ANDmike1/esp-/docs/hardware/01-requirements.md

# 01 — 需求冻结（电机电源驱动板）

| 项目 | 内容 |
|---|---|
| **项目名称** | 嵌赛 — 电机电源驱动板 |
| **工作模式** | **快速模式**（用户选择 A） |
| **日期** | 2026-05-06 |
| **用户授权** | 用户选择快速模式并指定范围「电机电源驱动板」，**授权对未填写项采用下文 [假设]**；你可随时更正任意一条。 |

---

## 工程约束表

| 维度 | 内容 | 状态 |
|---|---|---|
| **场景** | 竞赛/实验小车：双路直流电机驱动 + 逻辑/传感器供电；板载或独立电源模块 | [假设] |
| **供电输入** | 标称 **12 V** 蓄电池或适配器；母线需承受 **双电机同时堵转约 8 A 峰值**（单电机堵转约 4 A） | 已知（来自你先前说明） |
| **输出轨** | **12 V VM**；**5 V** 仅霍尔编码器；**3.3 V** 供 ESP32 板（IMU/超声/屏）；电流估算含 **1.5× 裕量**见 `04-constraints.md` | 已知 |
| **输入保护** | **无保险丝**；入口策略以 **肖特基** 为主（防反接串联等），详见 `03-components.md` | 已知 |
| **电机接口** | 左右电机功率端子 + 编码器/信号端子（与现有连接器语义一致即可） | [假设] |
| **通信/调试** | 无独立无线模块要求；以排针引出至主控板 | [假设] |
| **环境** | 室内赛项为主；**−20～+60 °C** 粗范围；无防水强制要求 | [假设] |
| **尺寸** | 与现有机械结构兼容；优先 **2 层板**、嘉立创工艺 | [假设] |
| **成本** | 学生/比赛预算，优先 LCSC/嘉立创可购 | [假设] |
| **认证** | 无强制 CE/FCC；课堂/赛场自用 | [假设] |
| **供应链偏好** | **混合折中**（关键功率/易损件可海外主流，连接器被动国产） | [假设] |
| **EDA** | **嘉立创 EDA**（与你当前工程一致） | [假设] |
| **制造** | 手工焊接比例高 → **优先可选贴片中较大封装**（你已反馈 TPS62135 焊接困难） | 已知 |

---

## 结构化优先级（快速模式默认）

未单独问卷时，采用以下默认取向（与「比赛迭代快 + 可焊性」一致）：

| 取向 | 本次默认 |
|---|---|
| 低功耗 | 次要（有线供电为主） |
| 低成本 | **重要**（但不以牺牲母线裕量为代价） |
| 快速落地 / 可调试 | **最重要** |
| 国产供应链 | **倾向混合**：电源芯片可 TI/成熟料，功率 MOS/驱动按 LCSC 备货选 |

若与你不符，请回复要改的 1～2 条即可。

---

## [假设] 清单（需你事后确认）

1. 主控不在本板，本板仅 **电源 + 双路电机驱动 + 去耦/保护**。  
2. **5 V / 3.3 V** 峰值电流单路 **≤ 2 A** 量级足够（若带多舵机需上调）。  
3. 输入允许 **反接保护** 以保险丝 + TVS 为主；是否加理想二极管/ORing 未强制。  
4. **LM2596** 作为 TPS62135 的「易焊备选」仅针对降压部分；需重新画原理图与布局，非 pin-to-pin。

---

## Gate 1 自检

- [x] 约束表已覆盖场景、供电、环境、成本、认证、供应链。  
- [x] 已给出优先级默认（快速落地 + 混合供应链）。  
- [x] **快速模式**：用户已选模式并指定题目，且授权假设推进。  

**下一步**：阅读 `02-architecture.md` 中三类架构对比并选定方向（若无回复则按文档中的**推荐方案 C**继续细化选型）。
