ANDmike1/esp-/docs/hardware/02-architecture.md

# 02 — 架构候选（电机电源驱动板）

| 项目 | 内容 |
|---|---|
| **项目名称** | 嵌赛 — 电机电源驱动板 |
| **日期** | 2026-05-06 |
| **用户锁定** | **方案 C**；降压采用用户库存 **LM2596 TO-263 固定 5 V / 固定 3.3 V**；**不设保险丝**（焊盘与实物不一致）；输入侧 **仅用肖特基**（见下文说明）；电感封装 **0650**；电机驱动 **AT8236**。 |

---

## 三类候选架构对比

| 方案 | 供应链取向 | 架构要点 | 关键器件范围 | 优点 | 缺点 | 适用 |
|---|---|---|---|---|---|---|
| **A — 国产优先** | 国产功率器件 + 国产/台系电源 | 双路 **集成 H 桥/驱动 IC**（如 AT8236 路线）+ **国产 DC-DC**（如 MP2315、XL7005 等，需按 12 V→5/3.3 V 具体选型）+ 输入 TVS/保险丝 | 驱动：集成方案；降压：MPS/矽力杰/芯洲等易购系列 | BOM 易在 LCSC 凑齐、成本可控 | 参考设计分散，需自己验证环路/EMI | 强国产化要求、成本敏感 |
| **B — 海外主流** | TI 等参考设计多 | **AT8236** + **TPS62135** 双路 Buck（3.3 V / 5 V）+ TVS + 保险丝；母线铺铜按 **8 A** 设计 | TPS62135、AT8236、SMBJ 系列 TVS | 效率与文档成熟、体积小 | **TPS62135 为 2×3 mm QFN**，手工焊接难度大（你已遇到） | 有小批量贴片或热风枪经验 |
| **C — 混合折中（推荐）** | 驱动维持成熟集成方案 + 降压改易焊封装 | **AT8236×2** + **LM2596-5.0 / LM2596-3.3（或 LM2596-ADJ）** 分立 Buck（TO-220/TO-263）+ 肖特基续流 + 功率电感；或 **SOIC-8 PowerPAD 类 TI TPS54331** 若体积可接受 | AT8236、LM2596、SS34/1N5822、电解/陶瓷 | **焊接友好**、调试直观、12 V 输入成熟 | 体积大、异步 Buck 效率低于同步方案、二极管与电感选型要多一步 | **课堂/比赛手工焊为主（与你现状最匹配）** |

---

## 推荐结论

- **默认推荐：方案 C（混合折中）**  
  - **理由**：与「手工焊接困难」「通电曾出现 5 V/3.3 V 短路需排查」等现状一致；LM2596 或 TO-263 贴片封装降低焊接门槛，便于排障。  
  - **方案 B** 保留为「体积紧凑 + 已能贴片」时的升级路径。  
  - **方案 A** 适合你把降压芯片进一步国产化时，需额外时间做电感/环路验证。

---

## 推荐系统框图（文本）

```
12V_IN ──[串联肖特基 防反接可选]──+── VM(12V) ──┬── AT8236(L) ── 电机L / 霍尔编码器供电出口
（不设保险丝）                    │              └── AT8236(R) ── 电机R / …
                                │
                                ├── LM2596-5.0(TO-263) ── 5V ──→ 仅双路霍尔编码器
                                │
                                └── LM2596-3.3(TO-263) ── 3.3V ──→ ESP32 板（IMU/超声/屏；OpenMV 多为串口）

GND：单板大面积铺地；浪涌保护若省略 TVS，则仅剩肖特基无法吸收高能尖峰 —— 见 `03-components` 风险提示。
```

---

## Gate 2 自检

- [x] 已比较国产优先 / 海外主流 / 混合三类。  
- [x] 每类均覆盖 **驱动 + 电源 + 保护** 范围。  
- [x] **用户已确认方案 C**，并补充电源结构与负载划分（见 `04-constraints` 电流估算）。
