ANDmike1/esp-/docs/hardware/04-constraints.md

# 04 — 接口、电源树、电流估算与 PCB 约束

| 项目 | 嵌赛 — 电机电源驱动板 |
|---|---|
| 日期 | 2026-05-06（修订） |
| 修订 | **高亮背光**：1.3″ 屏按 **亮色背光 TFT** 提高电流项并重算 ×1.5 |

---

## 负载说明（由你提供）

| 电源轨 | 本板上的用途 |
|---|---|
| **5 V** | 仅 **双路电机霍尔编码器**（无其它大电流外设） |
| **3.3 V** | 供 **ESP32 板**；板上外设含 **IMU、超声波、1.3″ 屏**；之后可能 **接 OpenMV（多为串口）** —— 通常 OpenMV 相机本机用 **USB 5 V** 独立供电，**若你坚持 OpenMV 也从本板 3.3 V 取电** 需另加一路预算（见下表注）。 |

**12 V VM**：双路 **AT8236**，单电机堵转约 **4 A**、两路同时约 **8 A 峰值**（与此前一致）；**无保险丝**，走线/接插件按此留裕量。

---

## 电流估算与 **1.5× 设计裕量**（工程估算，非测量值）

### 5 V 轨（霍尔编码器）

| 项 | 经验范围 | 本方案取值（说明） |
|----|---|---|
| 两路霍尔 + 上拉/接口 | 约 **20～80 mA** 量级（与具体编码器芯片、上拉阻值有关） | 取偏保守 **I₅,est ≈ 0.10 A（100 mA）** |
| **×1.5 余量** |  | **I₅,design ≈ 0.15 A** → **布线与 Buck 按 ≥ 0.2 A 能力备料** 即可（LM2596 能力远大于此，热与线宽压力很小） |

**结论**：5 V 走线 **0.3～0.5 mm 外层** 已很宽裕；重点在 **不要与 12 V/开关节点搞混极性**。

---

### 3.3 V 轨（ESP32 + IMU + 超声 + 1.3″ 屏）

以下按 **可能同时工作** 的偏保守加算（未计 OpenMV 从 3.3 V 强灌大电流）：

| 负载 | 经验电流（数量级） | 备注 |
|---|---|---|
| **ESP32-S3**（WiFi 开、一般业务） | **0.30～0.50 A** 持续，**发射尖峰** 可更高 | 无单独 RF 功率表时，用 **0.45 A** 作持续估算 |
| **IMU** | **~0.005 A** | I²C 芯片 |
| **超声测距**（如 HC-SR04 类） | **~0.015 A** 工作 | 间歇，与 WiFi 峰错开，但算进基线 |
| **1.3″ 屏（亮色背光 TFT）** | **约 0.15～0.22 A**（背光+驱动粗算，偏亮档位） | **已确认：背光由 3.3 V 供电**；取 **0.20 A** 计入 **I₃,base**，**不拆到 5 V 轨** |
| **小计 I₃,est** | 约 **0.45 + 0.005 + 0.015 + 0.20 ≈ 0.67 A** | — |
| **取整为基线负载（工程）** | **I₃,base ≈ 0.70 A** | 覆盖 WiFi 一般负载 + **高亮背光** 同时存在 |

**×1.5 余量（你要求）**

\[
I_{3,\mathrm{design}} = 1.5 \times I_{3,\mathrm{base}} \approx 1.5 \times 0.70\,\mathrm{A} \approx \mathbf{1.05\,\mathrm{A}}
\]

**设计建议（更新）：**

- **Buck / 电感 / TO-263 散热**：按 **连续 ~1.1 A** 为最低目标，**建议按 ~1.2 A** 连续能力布置 **铜宽、过孔、0650 电感 Isat**（纹波电流叠加后峰值更高，电感 **Isat** 建议 **≥ 2～3 A** 档位查阅手册曲线）。LM2596 芯片壳温与肖特基散热也要随之复核。  
- **PCB 走线**：**3.3 V 母线到 ESP32/屏供电分叉** 建议 **≥ 1.2 A** 档线宽或铺铜；分叉后 **屏供电窄段** 单独核一遍。  
- **去耦**：ESP32 模块电源脚附近 **≥ 100 µF 低 ESR 电解/固态 + 多层陶瓷**（具体按模组手册）。

**OpenMV 注**：若仅为 **UART/USB 透传**，相机仍 **USB 供电**，则 **不增加** 上述 **1.05 A**。若未来改为 **整相机由本板供电**，需单列预算。

---

## 汇总表（设计用）

| 轨 | 估算负载（长期） | **×1.5 后设计电流** | LM2596 |
|----|---|---|---|
| 5 V | ~0.10 A | **≥ ~0.15 A（建议按 0.2 A 档布置）** | TO-263 固定 5 V |
| 3.3 V | ~**0.70 A**（含 **高亮背光** 屏） | **≥ ~1.05 A（布线/Buck/电感按 ~1.2 A）** | TO-263 固定 3.3 V |
| 12 V VM | 峰值 ~8 A（电机） | **母线/器件不变** | — |

---

## PCB / 热（简要）

- **12 V**：仍建议 **铺铜 + 多过孔**；无保险丝则更依赖 **电池与线束不过载**。  
- **LM2596**：输入/输出电容紧靠脚位；续流二极管、电感环路最短；**0650 电感**注意 **饱和电流**。  
- **AT8236**：散热焊盘接地过孔。

---

## 产测顺序建议

1. **空载**：测 **5 V、3.3 V** 电压正确。  
2. **先仅接编码器 5 V**，再 **接 ESP32 3.3 V**（限流电源）。  
3. 最后再挂电机 **12 V** 大功率测试。
