ANDmike1/esp-/docs/hardware/06-decisions.md

# 06 — 决策门（修订）

| 类别 | 内容 |
|---|---|
| **已确定** | **方案 C**；**AT8236**；**LM2596 TO-263 固定 5 V / 3.3 V（库存）**；电感 **0650**；**取消保险丝**；入口仅用肖特基的方案需在板上标明是 **防反接串联**还是另有含义（见 `03`）；**检流电阻已改为 2512（≥2 W 档）**。 |
| **电流设计目标（含 1.5×）** | **5 V**：霍尔 → ~0.10 A，×1.5 → **≥0.15 A（布线 ~0.2 A）**。**3.3 V**：**屏背光由 3.3 V 供电**（已确认），亮色背光 → 基线 **~0.70 A**，×1.5 → **≥~1.05 A（建议布线/Buck/电感按 ~1.2 A）**；详见 `04-constraints`。 |
| **OpenMV** | 预设 **串口连接 + USB 独立供电**；若改为板供电须在改版需求中单列电流。 |
| **高风险** | 无保险丝/可选无 TVS → **浪涌与过流无熔断点**；务必核对 **线径、接插件、电池保护（若在外部）**。入口肖特基已定 **SK104B（SMB）**，注意 **铺铜散热**。 |
