ANDmike1/esp-/md/嵌赛全技能联调/本回合说明.md

# 嵌赛全技能联调 — 本回合说明

**日期**：2026-04-16  

## 覆盖的技能

| 技能 | 本回合验证方式 |
|---|---|
| `project-workspace-conventions` | 使用 `md/`、`code/` 约定；新建 `md/` 子目录归档本会话 md。 |
| `safe-file-operations` | 未执行高风险移动/删除；仅追加创建文件。 |
| `agent-session-md-archive` | 会话摘要文件夹名：`嵌赛全技能联调`；本会话相关 md 置于其下。 |
| `workspace-readme-changelog` | 根目录 `README.md` 仅写目录与用法；流水写入 `log.txt`。 |

## 说明

此为联调测试生成的文档，可随后续会话继续在同目录补充或按新摘要新建兄弟目录。
