ANDmike1/esp-/docs/hardware/03-components.md

# 03 — 关键器件选型（电机电源驱动板 · 方案 C · 已对齐库存）

| 项目 | 内容 |
|---|---|
| **日期** | 2026-05-06（修订） |
| **前提** | **AT8236×2**；**LM2596 TO-263 固定 5 V / 固定 3.3 V（已有物料）**；电感 **0650**；**无保险丝**；输入侧策略见下。**电流估算见 `04-constraints`。 |

> 下单前请在 LCSC/经销商再次核对料号与封装；参数以 **datasheet** 为准。

---

## 12 V 输入（用户要求：不要保险丝；仅用肖特基）

| 做法 | 说明 |
|---|---|
| **串联肖特基（典型用于防反接）** | 在 **12 V+** 串一只 **VRRM ≥ 40 V**、电流 ≥ 母线峰值（建议 ≥ **10～15 A** 脉冲能力档）的肖特基，反接时截止。**代价**：压降约 **0.3～0.5 V**，LM2596、AT8236 的 **最低输入电压**与发热需重算。 |
| **与你表述「只单独使用肖特基」** | 若 **不接 TVS**：无法替代保险丝的 **过流切断**；也无法替代 TVS 对 **感性尖峰/浪涌钳位**。比赛长线束仍建议 **并联一只 TVS 到地**（可与肖特基并存）。若结构上限死只用一颗二极管，优先弄清它是 **防反接串联** 还是误把 TVS 当肖特基 — **二者功能不同**。 |

**已从 BOM 删除**：保险丝及其焊盘。

---

## Buck（你已确认的物料）

| 轨 | 芯片（示例系列） | 封装 | 备注 |
|----|---|---|---|
| **5 V** | **LM2596** 固定 **5 V**（TO-263-5） | TO-263 | 负载仅占 **双路霍尔编码器**，电流极小（见 `04`）。 |
| **3.3 V** | **LM2596** 固定 **3.3 V**（TO-263-5） | TO-263 | 供 **ESP32 板**，含 IMU、超声、1.3″ 屏；OpenMV 多为 **UART**，相机通常 **USB 5 V 独立供电**，若不共 3.3 V 负载则不计入本轨电流。 |

- **续流二极管**：LM2596 异步 Buck 必选肖特基（如 **SS54 / MBR2045** 等，耐压与电流按 TI 典型应用）——与你「电源入口只用一颗肖特基」**不是同一颗**，此处为 **Buck 续流**。  
- **储能电感**：封装 **0650**（按你库存物料）；电感量仍在 **LM2596 手册典型范围（多为数十 µH）**，关键是 **Isat** 大于 **电感峰值电流**（按下面估算的 **1.5× 负载** + 纹波电流估算）。

---

## 电机驱动

| 模块 | 器件 | 备注 |
|---|---|---|
| 左/右电机 | **AT8236** | VM、采样电阻按此前堵转 **4 A/路**、母线 **8 A** 规划布线。 |

采购/datasheet 线索仍可用 LCSC 搜 **AT8236** / 原 C 号；以你实际下单料号为准。

---

## 小体积 Buck 备选（本板不优先）

- **TPS62135**：仅当你能稳定焊接 **2×3 mm QFN** 时；见历史记录。链接仍可用 [C167238](https://www.lcsc.com/product-detail/C167238.html) / [TI TPS62135 PDF](https://www.ti.com/lit/ds/symlink/tps62135.pdf)。

---

## 风险与验证动作（修订）

| 风险 | 建议 |
|---|---|
| 无保险丝、无 TVS | 过流/浪涌靠 **线束/电池/PCB 铜皮** 硬抗 → 线宽与接插件额定电流要够；**建议至少保留 TVS 或浪涌吸收** 二选一。 |
| 防反接肖特基压降 | 低电量时 **LM2596 压差** 不足会失稳；用 **示波器** 看 **最低电池电压** 下 5 V/3.3 V 是否仍稳。 |
| 3.3 V 电流被低估 | 见 `04` 的 **1.5× 表**；若给 **整板 OpenMV 5 V 供电** 从别处取，则不要算进 3.3 A。 |

---

## Gate 3 说明

- 批量下载 **LM2596、AT8236** 的 PDF 与 0650 电感规格书到 `docs/hardware/datasheets/` 可另开任务执行。
