ANDmike1/esp-/docs/hardware/07-bom.md

# 07 — BOM 表（电机电源驱动板 · 方案 C）

| 项目 | 内容 |
|---|---|
| **工程** | 嵌赛 — 电机电源驱动板 |
| **日期** | 2026-05-06 |
| **前提** | **无保险丝**；**LM2596 TO-263** 固定 **5 V / 3.3 V**；电感 **0650**；**AT8236×2**；屏背光 **3.3 V**、亮色负载已计入 `04-constraints`。 |

**说明**：下列 **LCSC 商品编号（C 号）** 为常用检索入口，**下单前请在立创商城按最终封装、耐压、阻值再次核对**；阻容精确值请在你原理图中按 LM2596 / AT8236 手册典型应用细化。

---

## 1. 汇总表（按位号）

| 序号 | 位号（建议） | 名称 | 型号 / 规格（示例） | 封装 | 数量 | LCSC（示例/检索） | 备注 |
|---|---|---|---|---|---|---|---|
| 1 | **J_IN** | 电源输入端子 | 2 Pin 3.81 mm 或同等 | 插件 | 1 | 搜「KF301」「螺钉端子 2P」 | 线径与电流≥母线峰值 |
| 2 | **D_IN** | 防反接肖特基 | **SK104B**（VRRM **40 V**）或同系列 **10 A / SMB（DO-214AA）** | **SMB** | 1 | 按订货型号搜 LCSC | **已确认可用**；入口 **铺铜散热**；串联 **压降 ~0.5 V@大电流** |
| 3 | **D_TV** | TVS（可选但强烈建议） | **SMBJ15CA** 或按电池钳位重选 | SMB | 1 | [C910054](https://www.lcsc.com/product-detail/C910054.html) 等 | 与「仅用肖特基」可并存；贴 **12 V–GND** |
| 4 | **C_VM_H** | VM 高频退耦 | **0.1 µF / 50 V** X7R | 0603/0805 | 2～4 | C 类陶瓷通用 | 紧靠 AT8236 VM / LM2596 Vin |
| 5 | **C_VM_B** | VM 储能电解 | **47 µF / 25 V**（或更大封装电解） | 径向/贴片电解 | 2 | 按封装选 | 近驱动 / 近电源入口分区放置 |
| 6 | **U1** | 电机驱动 | **AT8236_Left**（或兼容左封装） | ESOP-8 | 1 | [C2827823](https://www.lcsc.com/product-detail/C2827823.html) 等 | 以实际下单 Left/Right 料号为准 |
| 7 | **U2** | 电机驱动 | **AT8236_Right** | ESOP-8 | 1 | 同上系列 | 同上 |
| 8 | **R_SEN1/R_SEN2** | 检流电阻（若原理图保留） | **0.1 Ω** / **1%** / **≥2 W 量级** | **2512**（已由用户确认更换） | 2 | 搜「0R1 2512 2W」 | 开尔文布线；堵转约 **1.6 W** |
| 9 | **U3** | Buck 5 V | **LM2596S-5.0**（固定 5 V） | **TO-263-5** | 1 | 搜「LM2596S-5.0 TO-263」 | 你已持有物料则不改 |
| 10 | **U4** | Buck 3.3 V | **LM2596S-3.3**（固定 3.3 V） | **TO-263-5** | 1 | 搜「LM2596S-3.3 TO-263」 | 同上 |
| 11 | **D5** | LM2596（5 V）续流肖特基 | **≥40 V**、**≥3 A**（如 SS54、肖特基 TO-252） | SMA/插件 | 1 | 搜「SS54」「肖特基 5A」 | **非** D_IN |
| 12 | **D6** | LM2596（3.3 V）续流肖特基 | 同上 | 同上 | 1 | 同上 | 同上 |
| 13 | **L5** | Buck 5 V 储能电感 | **0650 封装**；电感量 **33～150 µH**（按 LM2596 公式与开关频率算） | 0650 | 1 | 按你库存料号 | **Isat ≥ 2～3 A** 推荐 |
| 14 | **L6** | Buck 3.3 V 储能电感 | 同上；**3.3 V 轨按 ~1.2 A 设计** | 0650 | 1 | 同上 | **Isat** 留足裕量 |
| 15 | **CIN5/CIN6** | LM2596 输入电容 | **100 µF / 25 V** + **0.1 µF** | 电解+0603 | 各 2 组 | 通用 | 各自紧靠 **U3/U4** Vin |
| 16 | **COUT5** | 5 V 输出滤波 | **220 µF / 16 V** + 陶瓷 **10 µF** | 电解+0603 | 1+1 | 通用 | 低温漂、低 ESR 更佳 |
| 17 | **COUT6** | 3.3 V 输出滤波 | **220～470 µF / 10 V** + **10 µF** | 同上 | 1+1 | 通用 | 供 ESP32 板入口 |
| 18 | **J_HALL** / **J_ENC** | 霍尔 / 编码器接口 | 排针 2.54 | 插件 | 若干 | — | 与机械结构一致 |
| 19 | **J_5V/J_3V3/J_GND** | 至 ESP32 / 外设 | 排针或锁紧座 | 插件 | 若干 | — | 电流能力≥ **1.2 A**（3.3 V） |
| 20 | **J_MOTOR_L/R** | 电机线 | 6 Pin 等（与原 PCB 一致） | 插件 | 2 | — | 见原理图网络名 |

---

## 2. 按功能块核对清单（不含结构件）

| 功能块 | 必含器件 |
|---|---|
| **12 V 入口** | 端子；可选 **D_IN**；可选 **D_TV**；VM 电解/陶瓷 |
| **双路驱动** | **U1/U2 AT8236**；VM 退耦；检流 **R_SEN**（若使用）；OUT 至端子 |
| **Buck 5 V** | **U3 LM2596-5**；**D5**；**L5**；Cin/Cout |
| **Buck 3.3 V** | **U4 LM2596-3.3**；**D6**；**L6**；Cin/Cout |
| **引出** | 5 V 霍尔；3.3 V ESP32；GND 充分 |

---

## 3. 已从 BOM 排除（与你的决策一致）

| 器件 | 原因 |
|---|---|
| **保险丝及焊盘** | 焊盘与实物不一致，已取消 |
| **TPS62135** | 焊接困难；改 LM2596 |

---

## 4. 订购前必须手算/核对的三项

1. **L5/L6 电感量**：用 TI LM2596 datasheet 或 Webench，按 **Vin=12 V**、**Vout=5/3.3 V**、电流 **~1.5～3 A 峰值能力** 选定 **µH**，不能只抄别人板。  
2. **Isat**：0650 电感饱和电流 **≥** 对应 Buck 峰值电感电流（含纹波）。  
3. **D_IN**：若不用防反接管，原理图标 **「绝不允许反接」**；若使用，核算 **最低电池电压** 下 LM2596 是否仍满足 **压差**。

---

## 5. 导出与归档

- 本表可与嘉立创 EDA **物料清单** 交叉校验：EDA 导出 BOM 后，将 **厂商型号、封装** 与本表 **规格列** 对齐。  
- 下一步若要 **合并进 PDF**，可按 `hardware-solution` 流程运行 `md_to_pdf.py`（见 `.cursor/skills`）。

---

## 6. 库存对照与电气核算（按你确认的序号）

**对照**：1✓ **2=SK104B（SMB 入口，已确认）** 3不用 4✓ 5直插铝电解 6✓7✓ **8=2512 0R1** 9✓10✓ 11✓12✓ 13=33µH 14✓ 15=100µF电解+0603 0.1µF 16✓17✓ 18✓19✓20✓  

### 6.1 结论总览

| 序号 | 结论 | 说明 |
|---|---|---|
| **2 入口肖特基** | **✅ SK104B（SMB）可用** | **IF(AV)=10 A** 档、**~8 A 堵转**在额定内；注意 **VF×I 发热**，阴极/阳极 **大面积铺铜**（见 VF 曲线 ~**0.5 V@10 A** 量级）。 |
| **8 检流 0.1 Ω** | **✅ 已改为 2512（用户确认）** | 堵转 **4 A** 时 **P≈1.6 W**：须选 **额定 ≥2 W** 的 **2512** 料号；保留 **开尔文** 至 AT8236 **ISEN**；焊接注意焊盘散热。 |
| **13 L5 = 33 µH（5 V 轨）** | **可用（粗算）** | **12 V→5 V**、负载按 **~0.2 A**、**f≈150 kHz** 量级粗算，纹波电流约 **0.5～0.6 A** 峰峰值量级时，电感电流峰值约 **0.2+0.3≈0.5 A** → **0650 电感 Isat ≥1 A** 通常即可；仍以 **数据手册 + 你手上电感的 Isat 实测曲线** 为准。 |
| **14 L6（3.3 V 轨）** | **须核对 Isat** | **输出按 ~1.2 A 设计** 时，粗算电感电流峰值 **≈ Iout + Δi/2**。若 **L6 也为 33 µH**、Vin=12 V，Δi 粗算仍约 **0.48 A** 量级，则 **IL_peak ≈ 1.2+0.24 ≈ 1.44 A**。请确认 **0650 料号 Isat ≥ 2 A**（推荐 **≥2.5 A**）。若 Isat 不足，改为 **更大 µH（降纹波）** 或 **更大饱和电流电感**。 |
| **11/12 续流肖特基（SS54 等）** | **一般够用** | LM2596 异步 Buck 续流二极管电流 **≈ 电感平均电流**，**5 V 路**很轻；**3.3 V 路**约 **1～1.5 A** 级，SS54 **5 A** 档通常有余量；仍以 **TO-263 LM2596 散热 + 二极管温升** 为准。 |
| **15 100 µF + 0603 0.1 µF** | **合理** | 输入电容：**电解（低频）+ 陶瓷（高频）** 经典搭配；注意 **100 µF 为电解**，**不能**做成 0603 本体——你是 **电解 + 0603 0.1 µF 并联**，表述正确。核对 **耐压 ≥25 V**。 |
| **3 不用 TVS** | **已接受风险** | 无钳位时浪涌靠线束与运气；赛场长线束仍建议日后补 **SMBJ** 类。 |
| **其余 1、4、5、6、7、9、10、16～20** | **齐套性 OK** | 按当前方案可装机；最终仍以 **原理图网络名与封装** 一致为准。 |

### 6.2 粗算公式（供你在手册里复核）

- **检流电阻功耗**：\(P \approx I^2 R\)（堵转 **4 A**、**0.1 Ω** → **≈1.6 W**）。  
- **Buck 纹波电流（量级）**：\( \Delta i_L \approx \dfrac{(V_{in}-V_{out})\,V_{out}}{V_{in}\,f_s\,L} \)（**LM2596** 请用手册中的 **\(f_s\)**；上表粗算按 **150 kHz** 量级示例）。  

### 6.3 建议优先处理的 2 件事

1. **入口二极管**：已选用 **SK104B（SMB）10 A** 档；装配时保证 **散热焊盘与铜皮**。若仍有异常温升，再考虑 **TO-252** 或取消串联防反接。  
2. ~~**检流电阻封装**~~ → **已改为 2512（≥2 W 档），请在 BOM 中核对具体料号额定功率。**

---

## 7. 下一步（衔接 `08-layout-and-bringup.md`）

- 原理图冻结 → PCB 关键网络 → 分阶段上电与 EVT；见 **`08-layout-and-bringup.md`**。
