ANDmike1/esp-/docs/hardware/05-validation.md

# 05 — 验证计划（EVT 摘要）

| 阶段 | 项目 | 方法 | 通过判据 |
|---|---|---|---|
| EVT-电 | 5 V / 3.3 V 空载 | 限流电源、万用表 | 电压在误差内，无异常升温 |
| EVT-电 | 12 V 带载电机 | 分段接电机、测电流 | 堵转电流与预期量级一致，驱动不过热 |
| EVT-可靠 | 过流/异常温升 | 实验室可控堵转、触摸热点 | **无板载保险**：依赖外部保护与人工断电；芯片不过热、无失控冒烟 |
| EVT-EMI | 母线纹波 | 示波器 VM、Vout | 纹波在 MCU/传感器可接受范围（按负载定） |
