ANDmike1/esp-/docs/hardware/08-layout-and-bringup.md

# 08 — 原理图收尾、PCB 要点与上电调试（电机电源驱动板）

| 项目 | 嵌赛 — 电机电源驱动板 |
|---|---|
| 日期 | 2026-05-06 |
| 前置 | **方案 C**；检流电阻已 **2512**；BOM 见 `07-bom.md`；电流见 `04-constraints.md`。 |

---

## 1. 原理图收尾清单（DRC 前）

| 检查项 | 说明 |
|---|---|
| **网络名统一** | **VM / 12V / GND / 5V / 3V3** 与 PCB 一致；避免同名不同网。 |
| **LM2596 固定输出** | **无 FB 分压电阻**（除非你用 ADJ）；**续流二极管方向**、**输入/输出电容极性**。 |
| **AT8236** | **VM**、**OUT**、**ISEN** 与 **2512 检流** 走线 **开尔文**；散热焊盘接 **GND**。 |
| **入口 SS54** | 若仍串联在总入口：与 **8 A 堵转** 是否匹配（见 `07-bom` §6）；否则标注 **「禁止反接」**。 |
| **无保险丝** | 原理图删除保险符号及多余网络，避免 DRC 悬空。 |

---

## 2. PCB 布局优先级（嘉立创 EDA）

| 优先级 | 区域 | 要点 |
|---|---|---|
| P0 | **12 V VM / 电机电流** | **铺铜 + 过孔**；**不换层细瓶颈**；从 **端子 → 电解 → AT8236 VM** 最短。 |
| P0 | **LM2596** | **Vin 电容贴脚**；**肖特基紧贴 SW**；**电感靠近 SW**；**开关节点面积小**。 |
| P1 | **2512 检流** | **取样脚独立** 进出芯片 **ISEN**，不与电机大电流铜皮混一段再走分支。 |
| P1 | **3.3 V 至排针** | 按 **~1.2 A** 布宽或铺铜至 **ESP32 供电针**。 |
| P2 | **丝印** | **12V/GND/5V/3V3**、**电机方向**、**极性电容**。 |

---

## 3. 分阶段上电（强烈建议）

| 步骤 | 操作 | 判据 |
|---|---|---|
| S1 | **限流电源** 仅接 **12 V 入口**（**不接电机**） | 无冒烟；各轨 **对地短路电阻** 正常（非近似短路）。 |
| S2 | 测 **5 V、3.3 V 空载电压** | **5.0±裕量 / 3.3±裕量**；LM2596、二极管微热可接受。 |
| S3 | 接 **霍尔 5 V** | 编码器工作正常。 |
| S4 | 接 **ESP32 3.3 V**（可先低压限流） | 起机、屏、WiFi 粗测。 |
| S5 | 最后接 **电机 + 逐渐加大负载** | 堵转电流与温升可接受；检流波形（若有）合理。 |

---

## 4. 与 `05-validation.md` 的衔接

- **EVT-电**：对应上表 **S2～S4**。  
- **EVT-带载电机**：对应 **S5**。  
- **无保险丝**：「短路保护」一项改为 **依赖外部电池保护 / 线径 / 人工断电**，板内无熔断。

---

## 5. 完成后

- **Gerber** 导出 → 嘉立创下单助手；首板建议 **加测试点（TP）** 于 **VM、5V、3V3、GND**。  
- **投产前整板核对**：见 **`09-pre-order-checklist.md`**。
