ANDmike1/esp-/PCB.pdf

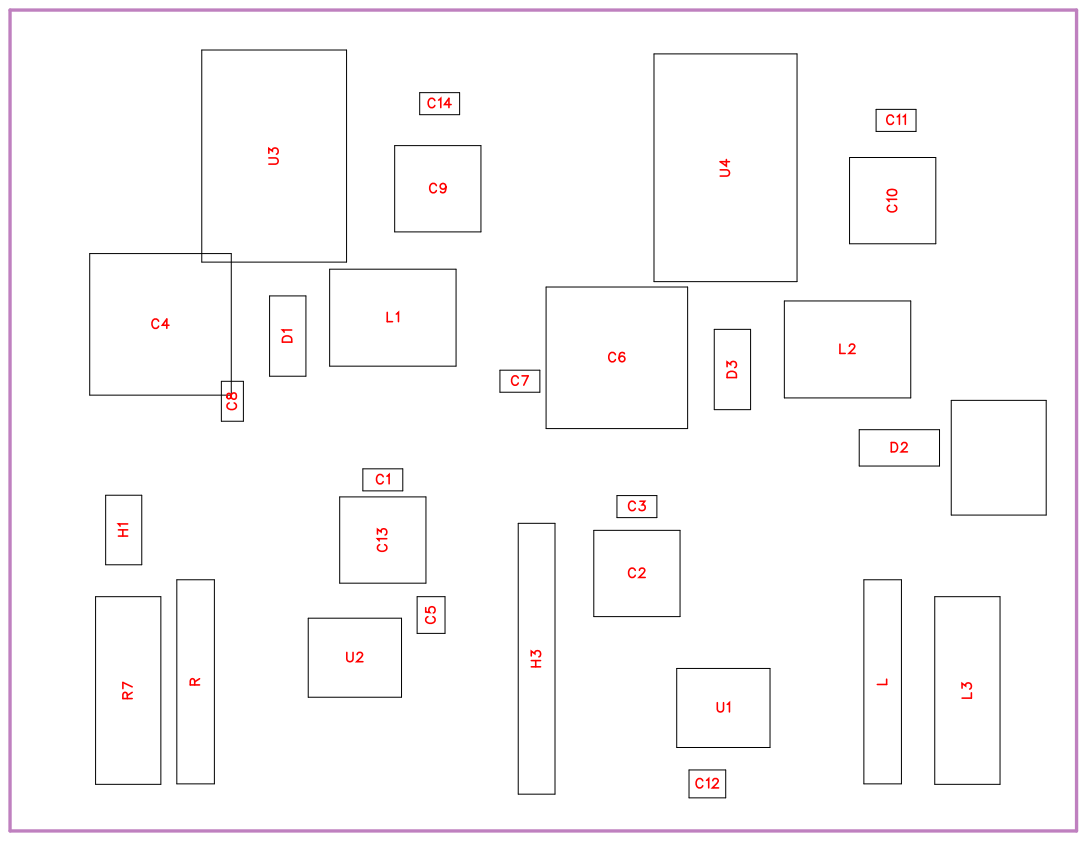
[picture p1: page 1]

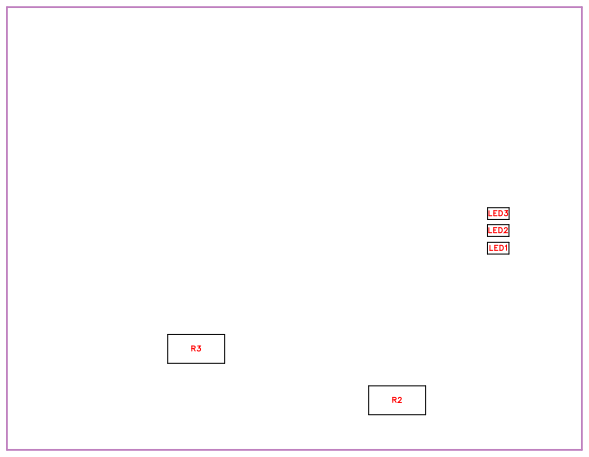
[picture p2: figure]
LED1; LED2; LED3

No. | Quantity | Comment | Designator | Footprint | Value | Manufacturer Part | Manufacturer | Supplier Part | Supplier
1 | 2 | 陶瓷电容0.1u f | C1,C3 | C0603 | 陶瓷电容0.1u f
2 | 2 | 47uF | C2,C13 | CAP-TH_BD 6.3-P2.50-D1 .0-FD | 47uF | ERS1HM470 E110T | AISHI(艾华集 团) | C106665 | LCSC
3 | 2 | 680uF | C4,C6 | CAP-TH_BD 10.0-F5.00-D 0.6-FD | 680uF | ERG35V680 M10X16 | JIERR(捷而 瑞) | C47344182 | LCSC
4 | 2 | 100nF | C5,C12 | CAP-SMD_L 2.0-W1.25 | 100nF | FCC0805B10 4K500DT | FOJAN(富捷) | C5137467 | LCSC
5 | 2 | 0.1uf | C7,C8 | C0603 | 0.1uf
6 | 2 | 220uF | C9,C10 | CAP-TH_BD 6.3-P2.50-D0 .5-FD | 220uF | ERG25V220 M6X11 | JIERR(捷而 瑞) | C47344177 | LCSC
7 | 2 | 10uf | C11,C14 | C0603 | 10uf
8 | 3 | SS54 | D1,D2,D3 | SMA_L4.3-W 2.6-LS5.0-FD | | SS54 | R+O(宏嘉诚) | C7420369 | LCSC
9 | 1 | PZ254V-11-0 2P | H1 | HDR-TH_2P-P2.54-V-M | | PZ254V-11-0 2P | XFCN(兴飞) | C492401 | LCSC
10 | 1 | PZ254V-11-0 8P | H3 | HDR-TH_8P-P2.54-V-M | | PZ254V-11-0 8P | XFCN(兴飞) | C492407 | LCSC
11 | 2 | 33uH | L1,L2 | IND-SMD_L7 .5-W6.6 | 33uH | PCR0650-33 0-M | JIERR(捷而 瑞) | C53896885 | LCSC
12 | 2 | 2016WV-06P | L3,R7 | CONN-TH_X 2016WV-06-46SN | | 2016WV-06P | HanElectricit y(瀚源) | C5448081 | LCSC
13 | 2 | A254UP-ZD0 6P | L,R | HDR-TH_6P-P2.54-V-M | | A254UP-ZD0 6P | BXCONN(宝 讯) | C41413835 | LCSC
14 | 3 | NCD0603Y2 | LED1,LED2,LED3 | LED0603-RD | | NCD0603Y2 | 国星光电 | C89811 | LCSC
15 | 2 | 100m | R2,R3 | R2512 | 100m | RE2512F3R1 00 | JIERR(捷而 瑞) | C46961760 | LCSC
16 | 1 | AT8236_Left | U1 | ESOP-8_L4. 9-W3.9-P1.2 7-LS6.0-BL-E P | | AT8236_Left | 杭州中科微 | C2827823 | LCSC
17 | 1 | AT8236_Rig ht | U2 | ESOP-8_L4. 9-W3.9-P1.2 7-LS6.0-BL-E P | | AT8236_Rig ht | 杭州中科微 | C2827823 | LCSC
18 | 1 | LM2596S-5.0 (UMW) | U3 | TO-263-5_L1 0.2-W8.9-P1. 70-BR | | LM2596S-5.0 (UMW) | UMW(友台半 导体) | C347421 | LCSC
19 | 1 | LM2596S-3.3 (UMW) | U4 | TO-263-5_L1 0.0-W8.4-P1. 70-LS15.3-B R | | LM2596S-3.3 (UMW) | UMW(友台半 导体) | C347420 | LCSC

20

1 | 1*2PIN
3.81mm
电源接线端子 | CONN-TH_
WJ15EDGV
C-3.81-2P

1*2PIN
3.81mm

KANGNEX(
康奈克斯电气 )

C8396 LCSC

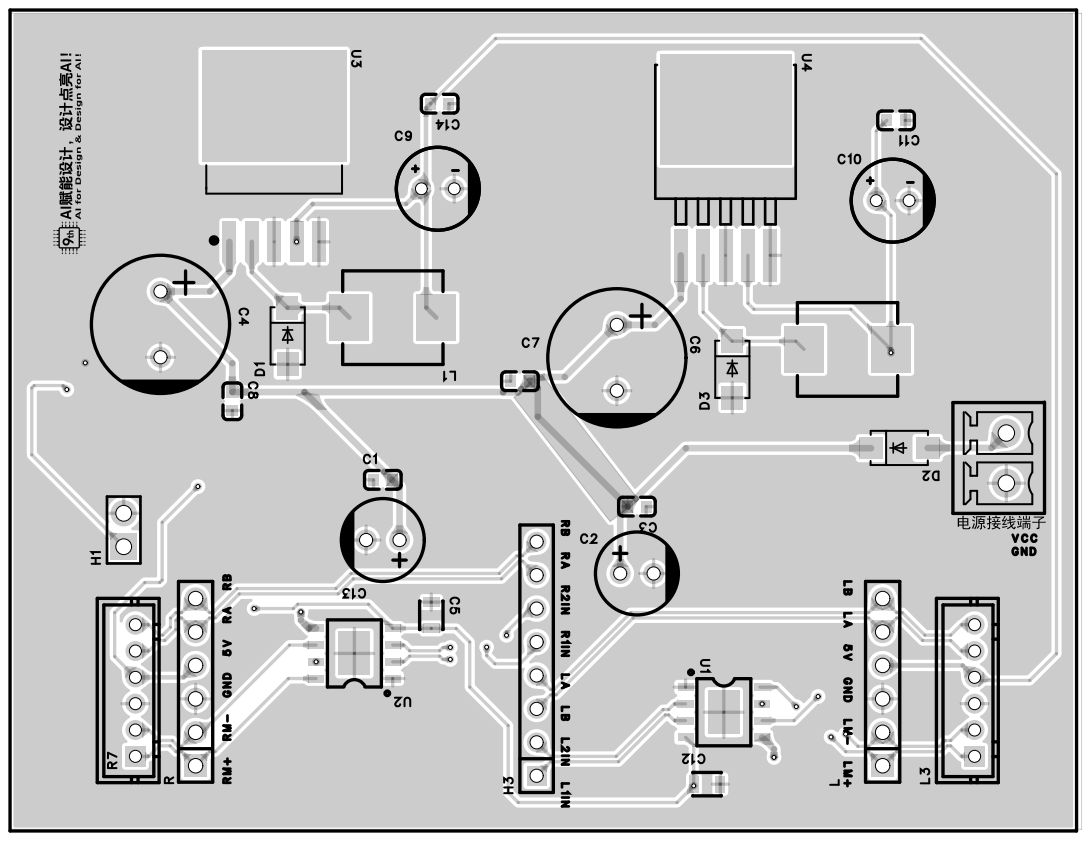
[picture p3: page 5]

LB LA 5V GND LM- LM+

RM+ RM- GND 5V RA RB

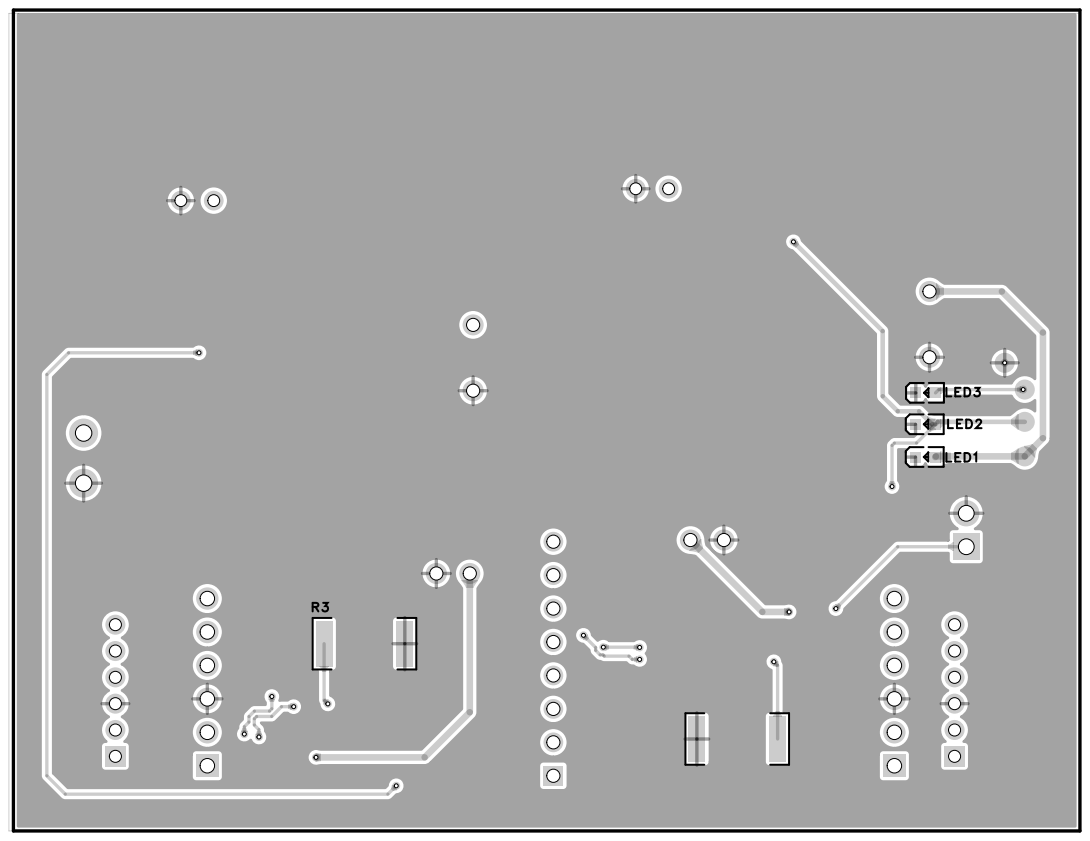
[picture p4: page 6]

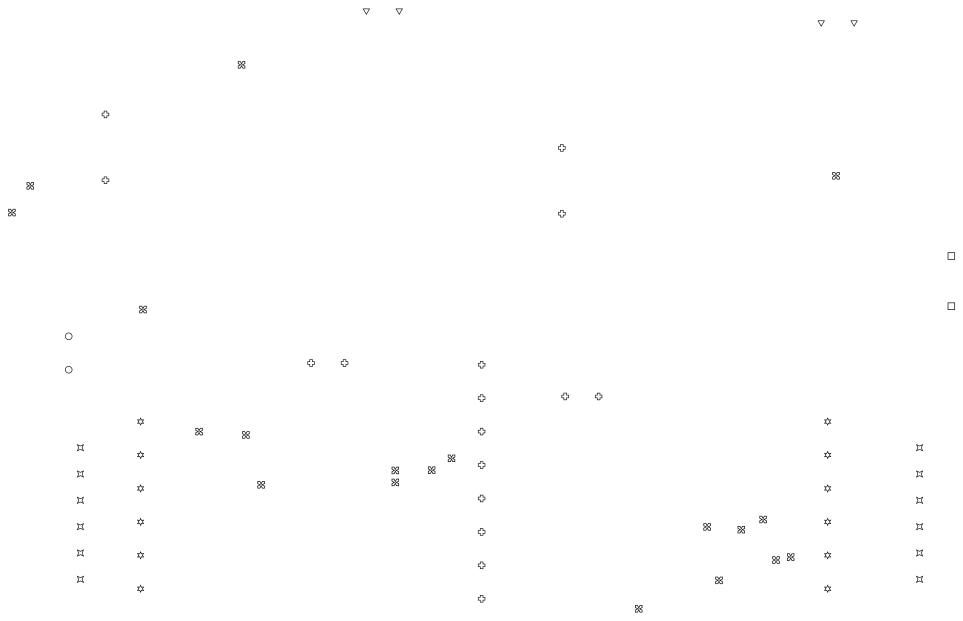
[picture p5: page 7]
