ANDmike1/esp-/数据手册/ATK_DNESP32S3_V1.2.pdf

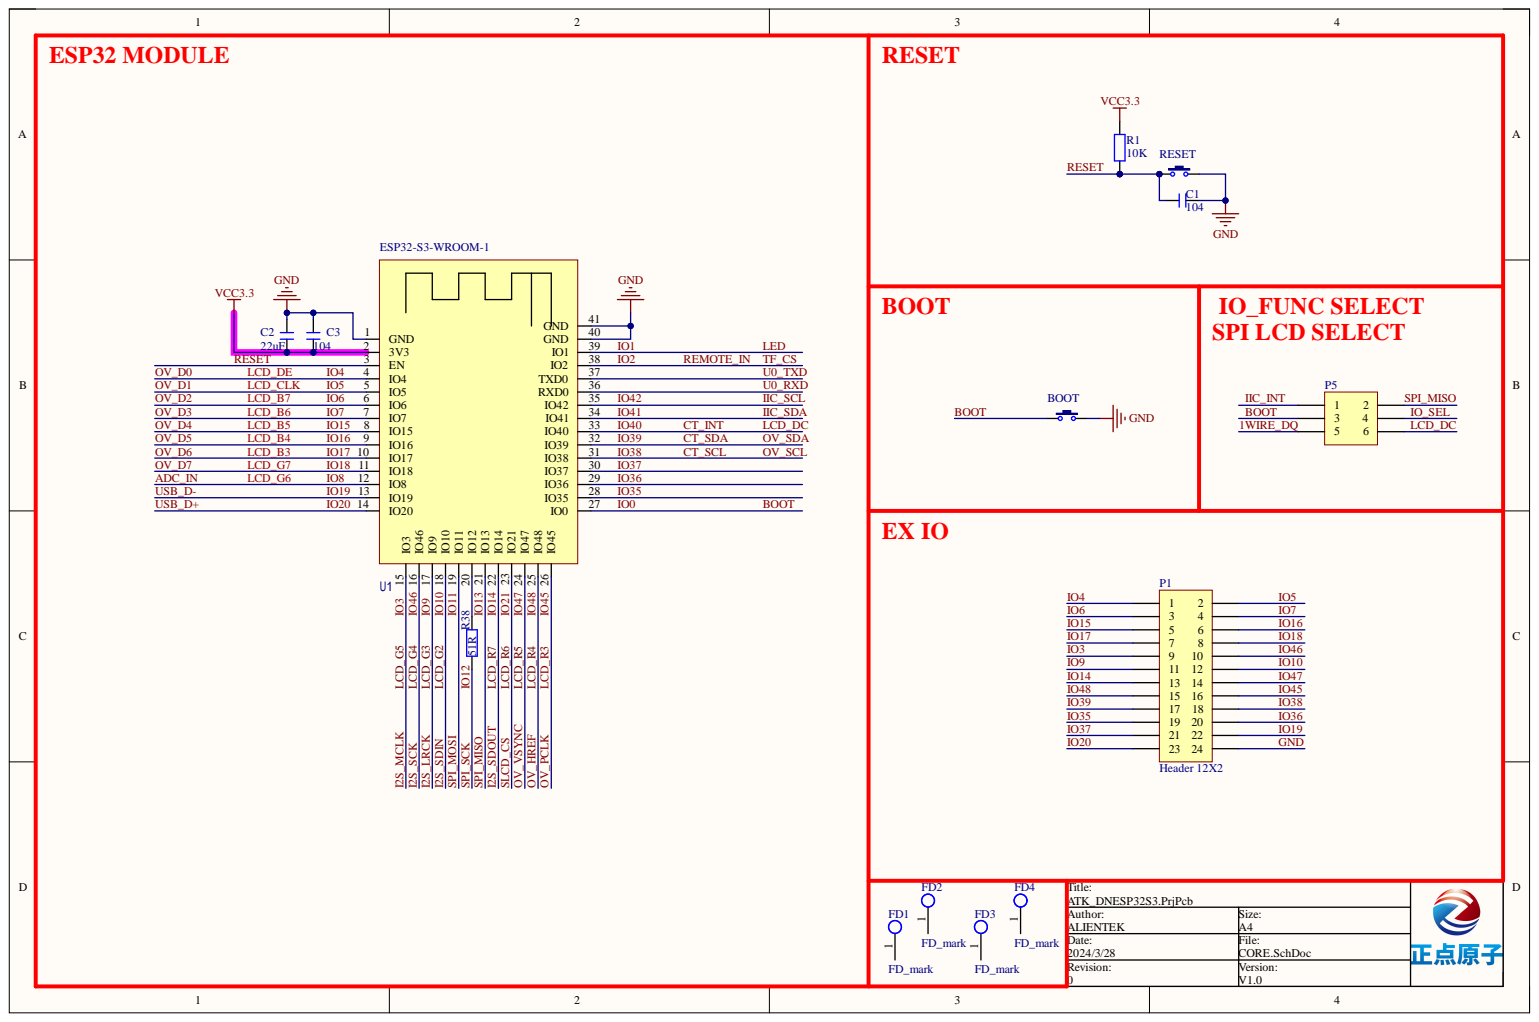
[picture p6: page 1]

GND 1 3V3 2

FD_mark | Title: ATK_DNESP32S3.PrjPcb

Author: ALIENTEK | Size: A4

Date: 2024/3/28 | File: CORE.SchDoc

Revision: | Version: V1.0

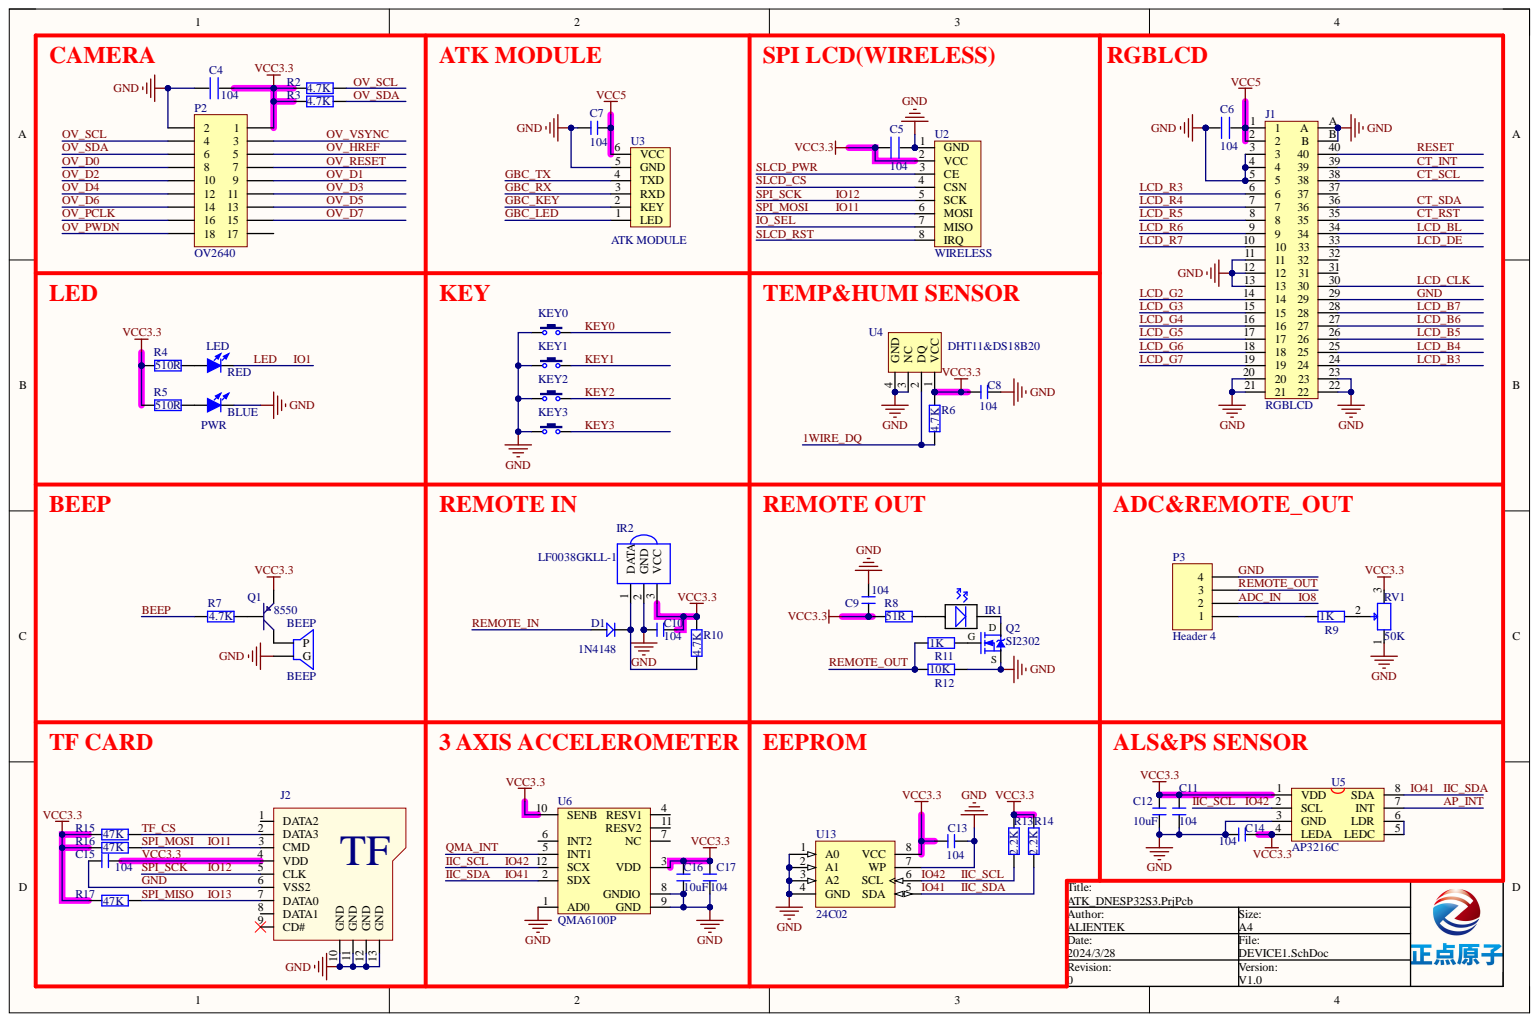
[picture p7: page 2]

VCC 1 DQ 2 NC 3 GND 4

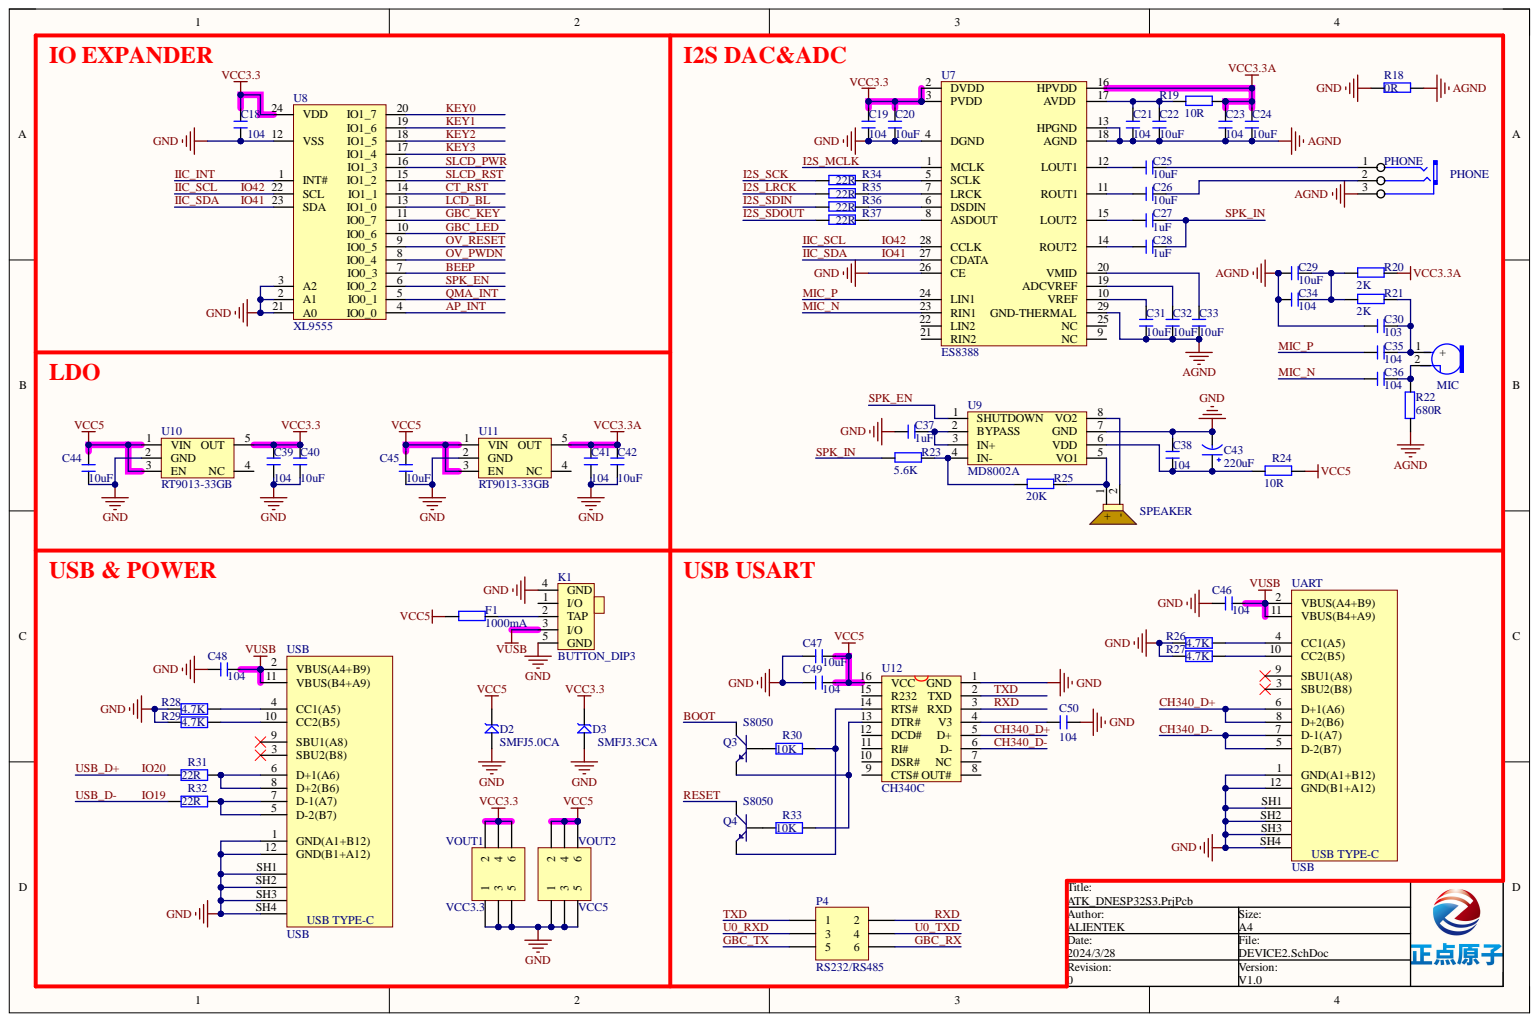
[picture p8: page 3]

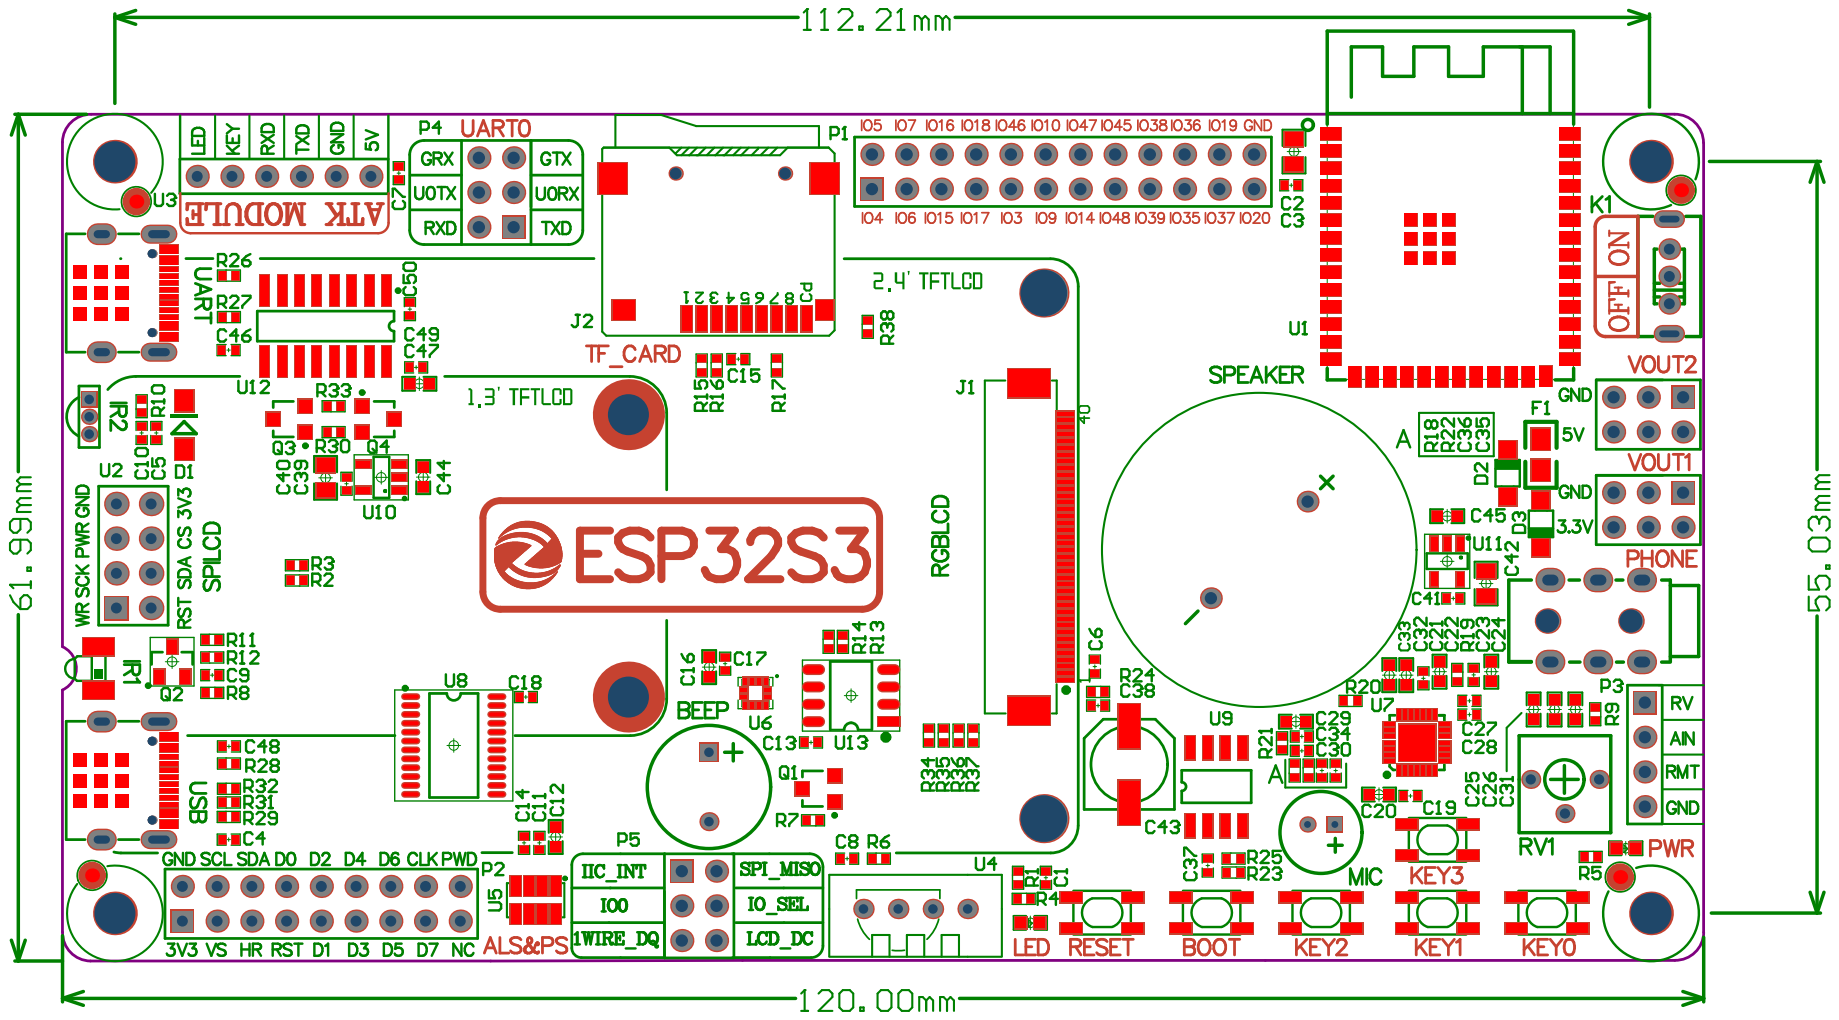
[picture p9: page 4]

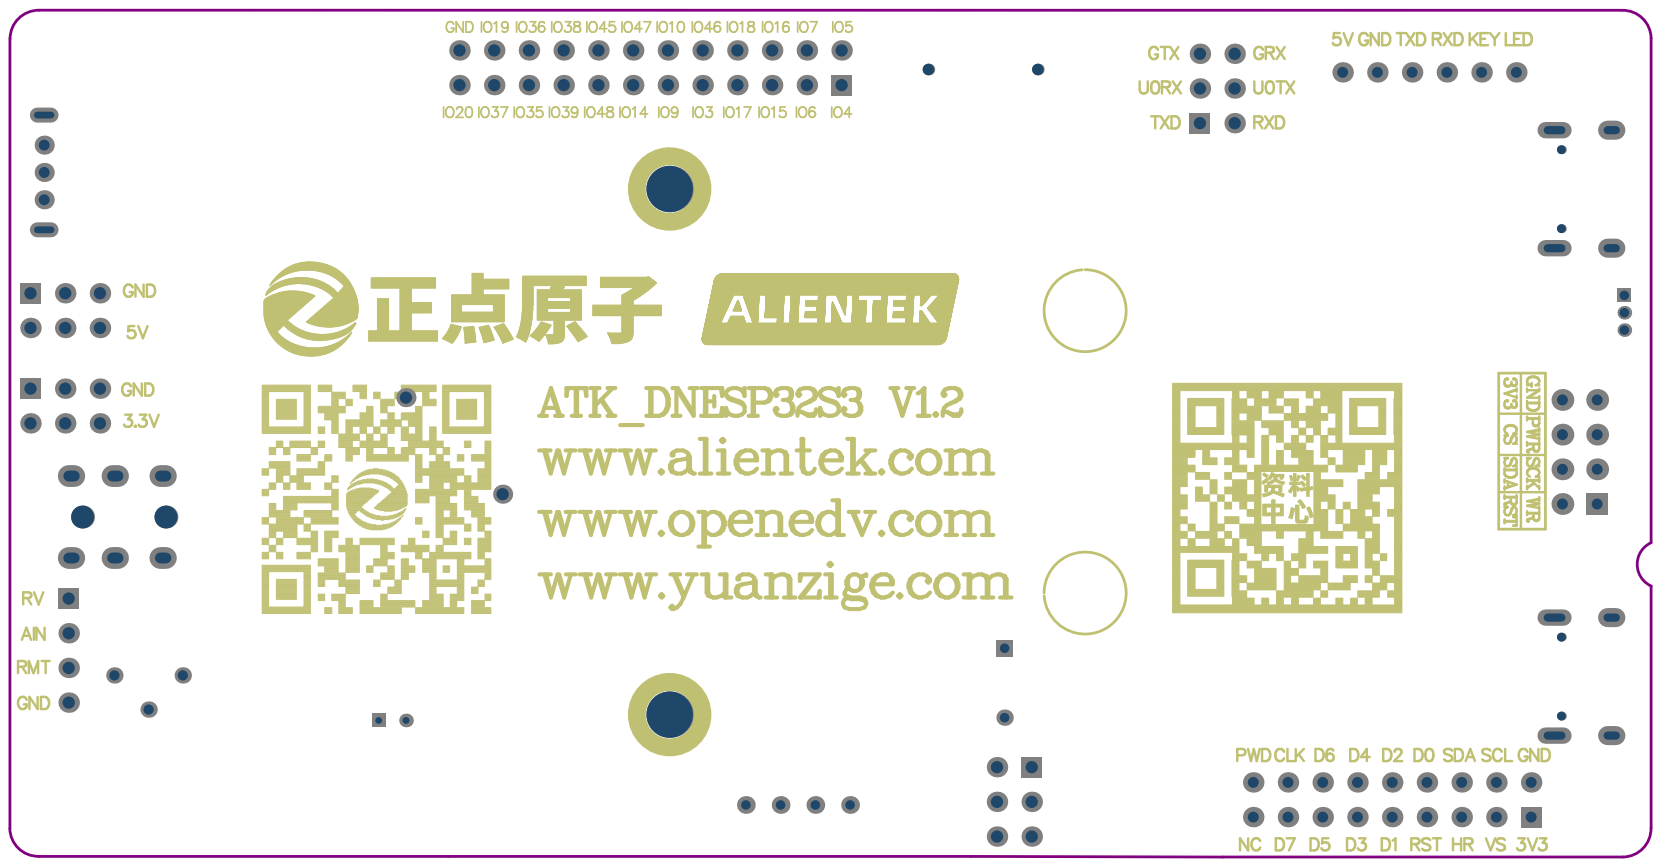
[picture p10: page 5]
