ANDmike1/esp-/ESP32S3_Phone_HTTP_Cmd/ESP32S3_Phone_HTTP_Cmd.ino

��拟器\MuMuPlayer\configs\install_config.json, displayText: Path not found: D:\模拟器\MuMuPlayer\configs\install_config.json
[20260414:15:20:14:040][T-10] Information: [24220] [ConfigJson::load] load json: D:\模拟器\MuMuPlayer\configs\install_config.json
[20260414:15:20:14:056][T-10] Information: [24220] [ConfigJson::load] poco crash code: 3, message: D:\模拟器\MuMuPlayer\configs\install_config.json, displayText: Path not found: D:\模拟器\MuMuPlayer\configs\install_config.json
[20260414:15:20:14:125][T-10] Information: [24220] [ConfigJson::load] load json: D:\模拟器\MuMuPlayer\configs\install_config.json
[20260414:15:20:14:140][T-10] Information: [24220] [ConfigJson::load] poco crash code: 3, message: D:\模拟器\MuMuPlayer\configs\install_config.json, displayText: Path not found: D:\模拟器\MuMuPlayer\configs\install_config.json
[20260414:15:20:14:148][T-10] Information: [24220] [ConfigJson::load] load json: D:\模拟器\MuMuPlayer\configs\install_config.json
[20260414:15:20:14:165][T-10] Information: [24220] [ConfigJson::load] poco crash code: 3, message: D:\模拟器\MuMuPlayer\configs\install_config.json, displayText: Path not found: D:\模拟器\MuMuPlayer\configs\install_config.json
[20260414:15:20:14:221][T-10] Information: [24220] [ConfigJson::load] load json: D:\模拟器\MuMuPlayer\configs\install_config.json
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
[20260414:15:20:15:621][T-10] Information: [24220] [ConfigJson::load] load json: D:\模拟器\MuMuPlayer\configs\install_config.json
[20260414:15:20:15:632][T-10] Information: [24220] [ConfigJson::load] poco crash code: 3, message: D:\模拟器\MuMuPlayer\configs\install_config.json, displayText: Path not found: D:\模拟器\MuMuPlayer\configs\install_config.json
[20260414:15:20:15:649][T-10] Information: [24220] 
