ANDmike1/esp-/(commit log)

2026-04-25 update: 新增并更新文件
2026-04-25 feat:使用霍尔编码器实现速度测量并且在网站上添加显示
2026-04-27 测试无线烧录
2026-04-27 添加显示
2026-04-27 无线烧录测试
2026-04-27 实现远程OTA烧录
2026-04-27 添加KEY0切换显示
2026-04-27 实现OTA远程烧录
2026-05-02 修复HTML调用栈过深导致持续复位的问题
2026-05-02 修复调用栈过深导致持续复位问题+软件控制电机安全启动
2026-05-02 更换DCDC芯片
2026-05-03 添加左右转参数控制
2026-05-03 添加左右转控制
2026-05-03 添加左右转控制修正前进后退偏航问题
2026-05-04 添加openmv识别人像
2026-05-06 使用AI工具进行pcb设计
2026-05-18 测试新电机驱动板是否能够使用
2026-05-18 使用新电机驱动板实现原有逻辑
2026-05-18 使用新驱动板实现功能
2026-05-18 使用新板子实现功能
